zishuocan/LCR/.agents/pcb.png

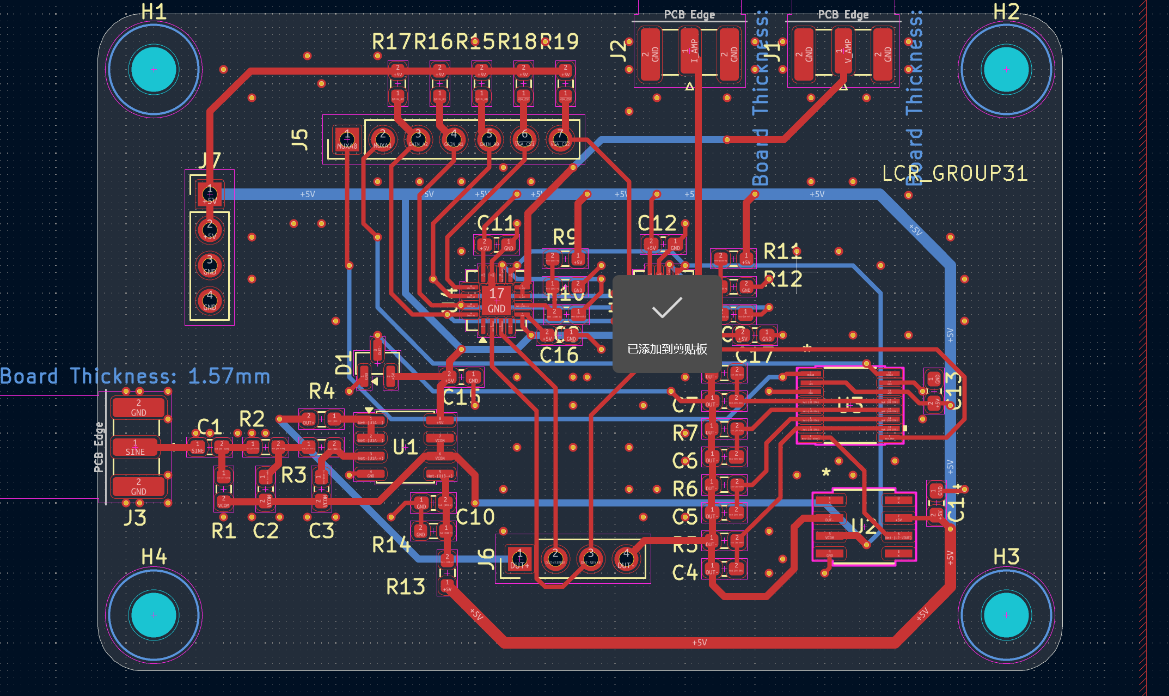
.agents/pcb.png
