zishuocan/LCR/.agents/原理图.png

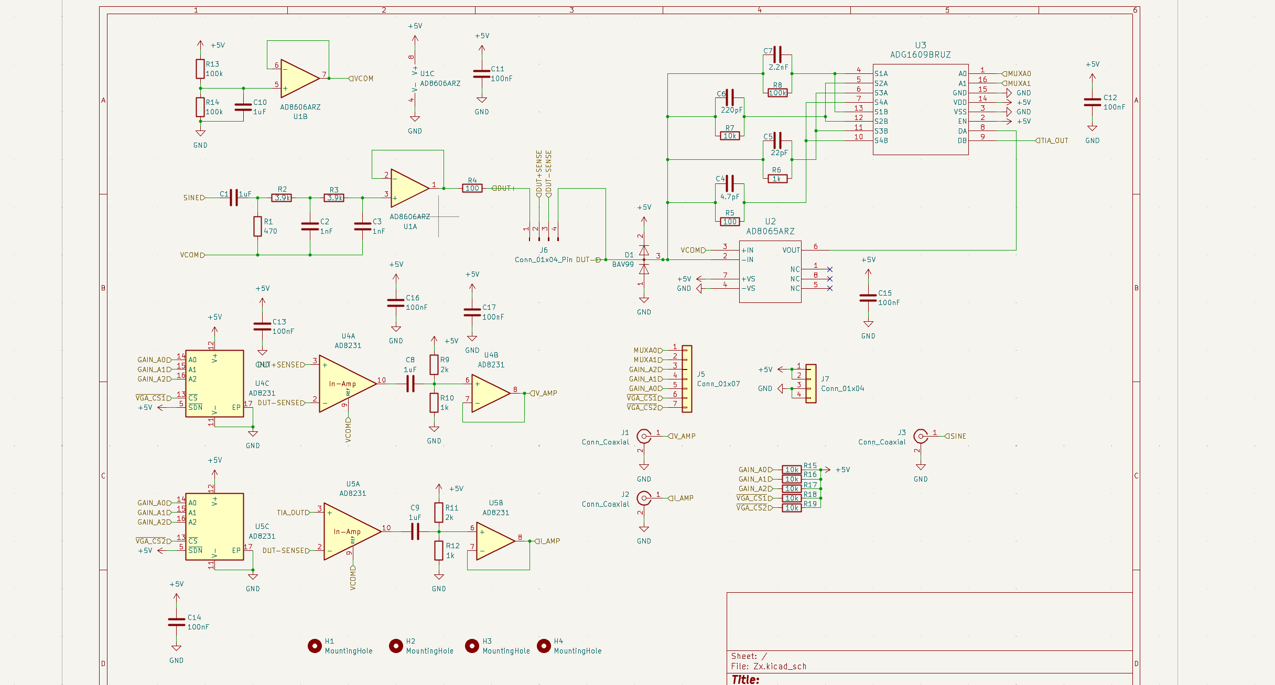
.agents/原理图.png
