zishuocan/LCR/LCR.ioc

Mcu.UserName=STM32G474RETx
PA0.Signal=ADC1_IN1
PA1.Signal=ADC2_IN2
PA13.GPIO_Label=T_SWDIO
PA13.Signal=SYS_JTMS-SWDIO
PA14.GPIO_Label=T_SWCLK
PA14.Signal=SYS_JTCK-SWCLK
PA2.Signal=LPUART1_TX
PA3.Signal=LPUART1_RX
PA4.Signal=COMP_DAC11_group
PA8.GPIO_Label=MUX_A1
PA8.Signal=GPIO_Output
PA9.GPIO_Label=GAIN_A2
PA9.Signal=GPIO_Output
PB10.GPIO_Label=MUX_A0
PB10.Signal=GPIO_Output
PB3.GPIO_Label=T_SWO
PB3.Signal=SYS_JTDO-SWO
PB4.GPIO_Label=VGA_CS2
PB4.Signal=GPIO_Output
PB5.GPIO_Label=VGA_CS1
PB5.Signal=GPIO_Output
PB6.GPIO_Label=GAIN_A0
PB6.Signal=GPIO_Output
PB8-BOOT0.Signal=I2C1_SCL
PB9.Signal=I2C1_SDA
PC14-OSC32_IN.GPIO_Label=RCC_OSC32_IN
PC14-OSC32_IN.Signal=RCC_OSC32_IN
PC15-OSC32_OUT.GPIO_Label=RCC_OSC32_OUT
PC15-OSC32_OUT.Signal=RCC_OSC32_OUT
PC7.GPIO_Label=GAIN_A1
PC7.Signal=GPIO_Output
PF0-OSC_IN.GPIO_Label=RCC_OSC_IN
PF0-OSC_IN.Signal=RCC_OSC_IN
PF1-OSC_OUT.GPIO_Label=RCC_OSC_OUT
PF1-OSC_OUT.Signal=RCC_OSC_OUT
