zishuocan/LCR/Core/Inc/main.h

#define RCC_OSC32_IN_Pin GPIO_PIN_14
#define RCC_OSC32_IN_GPIO_Port GPIOC
#define RCC_OSC32_OUT_Pin GPIO_PIN_15
#define RCC_OSC32_OUT_GPIO_Port GPIOC
#define RCC_OSC_IN_Pin GPIO_PIN_0
#define RCC_OSC_IN_GPIO_Port GPIOF
#define RCC_OSC_OUT_Pin GPIO_PIN_1
#define RCC_OSC_OUT_GPIO_Port GPIOF
#define MUX_A0_Pin GPIO_PIN_10
#define MUX_A0_GPIO_Port GPIOB
#define GAIN_A1_Pin GPIO_PIN_7
#define GAIN_A1_GPIO_Port GPIOC
#define MUX_A1_Pin GPIO_PIN_8
#define MUX_A1_GPIO_Port GPIOA
#define GAIN_A2_Pin GPIO_PIN_9
#define GAIN_A2_GPIO_Port GPIOA
#define T_SWDIO_Pin GPIO_PIN_13
#define T_SWDIO_GPIO_Port GPIOA
#define T_SWCLK_Pin GPIO_PIN_14
#define T_SWCLK_GPIO_Port GPIOA
#define T_SWO_Pin GPIO_PIN_3
#define T_SWO_GPIO_Port GPIOB
#define VGA_CS2_Pin GPIO_PIN_4
#define VGA_CS2_GPIO_Port GPIOB
#define VGA_CS1_Pin GPIO_PIN_5
#define VGA_CS1_GPIO_Port GPIOB
#define GAIN_A0_Pin GPIO_PIN_6
#define GAIN_A0_GPIO_Port GPIOB
