zishuocan/LCR/(commit log)

2026-07-20 对于电容测量阈值太高，已经拉低
    [LCR验收测量记录.xlsx]
2026-07-22 恢复了100k反馈
2026-07-23 尝试校准反馈
    [LCR验收测量记录.xlsx]
2026-07-23 优化测量结果屏幕显示
2026-07-23 优化了屏幕显示内容
    [LCR验收测量记录.xlsx]
